Krishnanshu06/hexapud/docs/assets/d_loop_trajectory.png

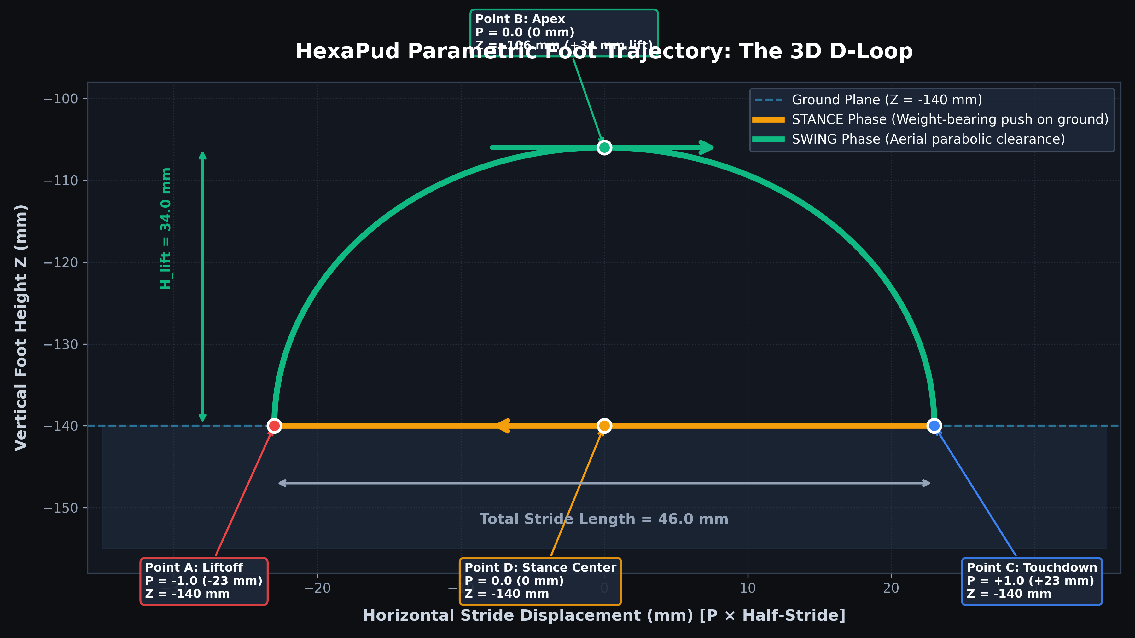
docs/assets/d_loop_trajectory.png
