Krishnanshu06/hexapud/docs/assets/inverse_kinematics_diagram.png

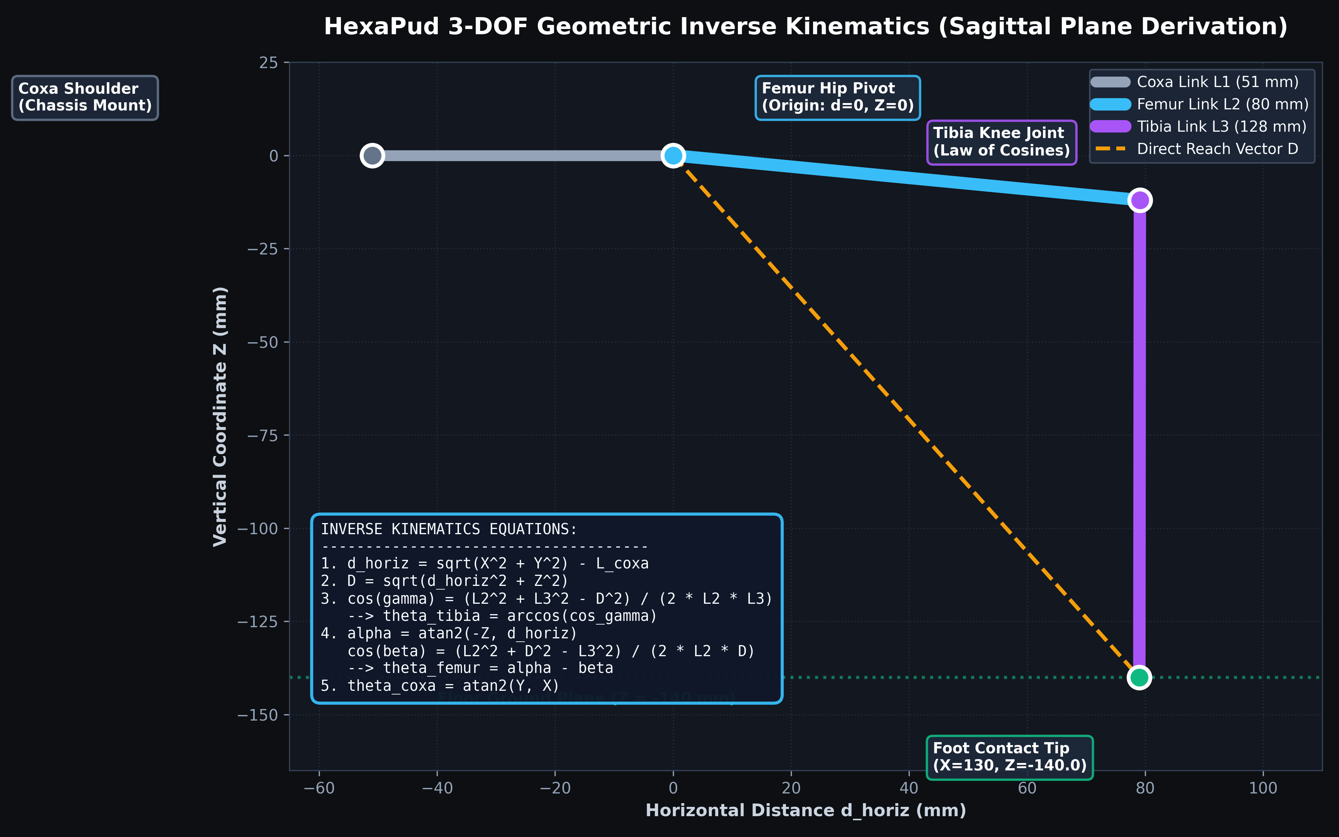
docs/assets/inverse_kinematics_diagram.png
