Krishnanshu06/hexapud/cad/body/body_main_top.3mf

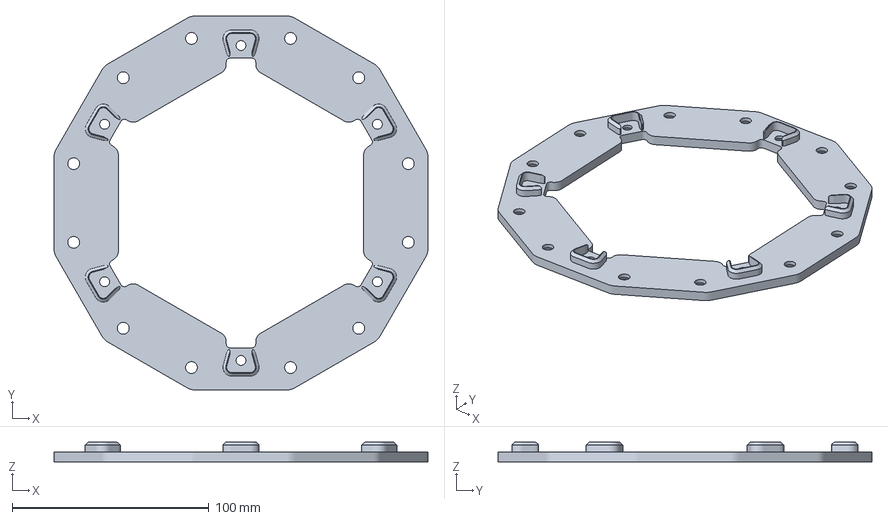
[picture p8: CAD file, 2026-10-30]
cad/body/body_main_top.3mf
190.0 x 190.0 x 10.0 mm
