Krishnanshu06/hexapud/cad/body/body_main_bottom.3mf

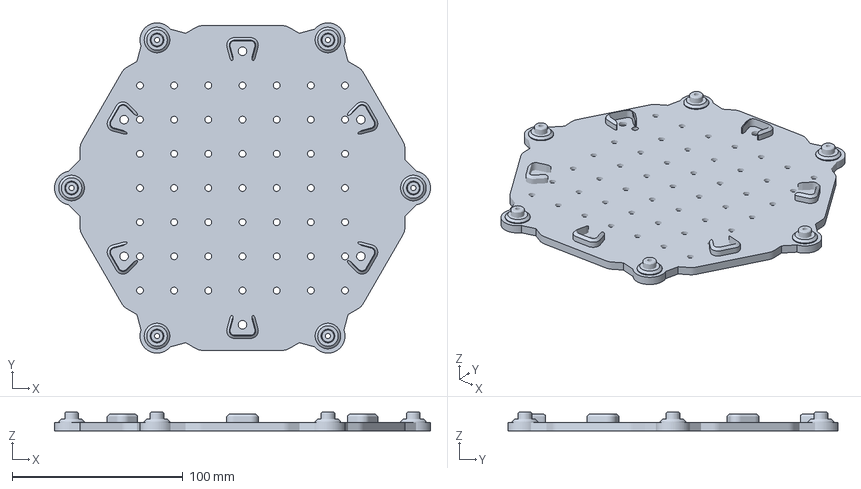
[picture p9: CAD file, 2026-10-30]
cad/body/body_main_bottom.3mf
220.0 x 193.2 x 11.0 mm
