Krishnanshu06/hexapud/cad/body/body_spacer_set.3mf

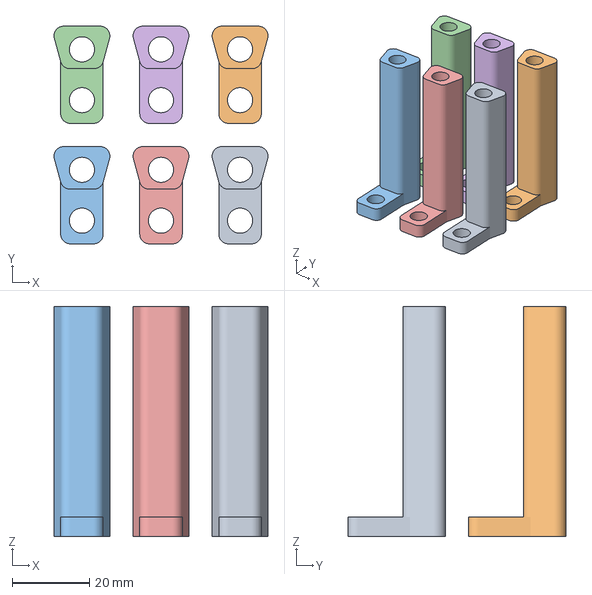
[picture p10: CAD file, 2026-10-30]
cad/body/body_spacer_set.3mf
55.4 x 56.3 x 59.5 mm
