Krishnanshu06/hexapud/cad/legs/common/bushing.stl

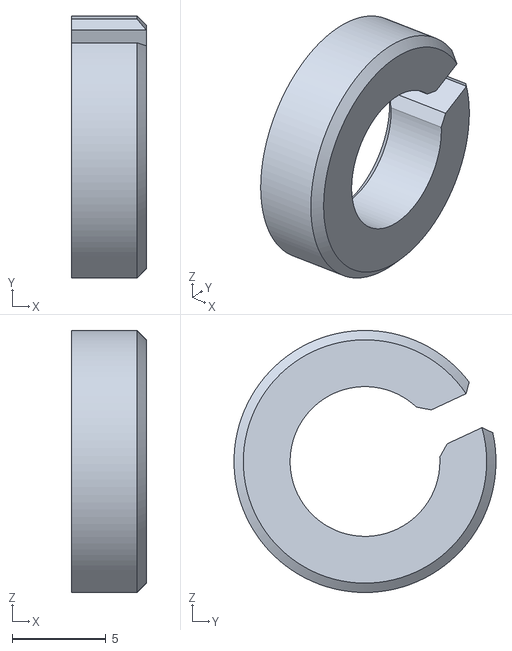
[picture p11: CAD file, 2026-10-30]
cad/legs/common/bushing.stl
4.00 x 14.0 x 14.0
