Krishnanshu06/hexapud/cad/legs/left_leg_mirrored/leg_set_mirrored.stl

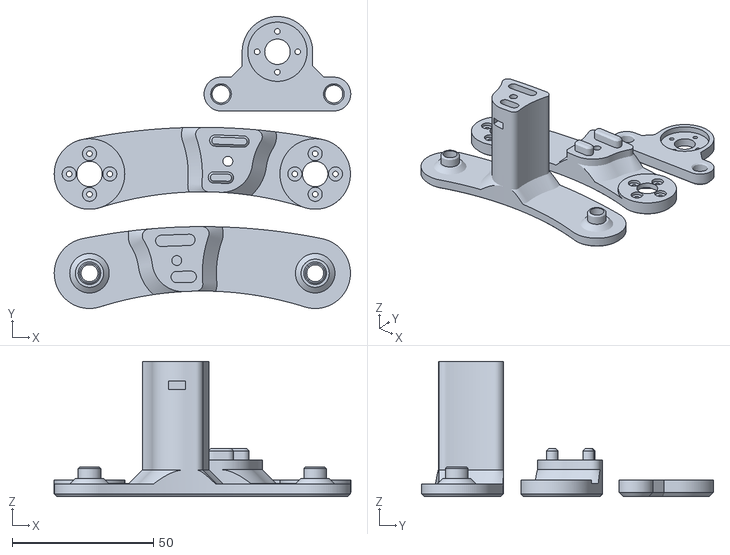
[picture p12: CAD file, 2026-10-30]
cad/legs/left_leg_mirrored/leg_set_mirrored.stl
105.1 x 103.5 x 48.0
