Krishnanshu06/hexapud/cad/legs/right_leg/femurSlimPart.stl

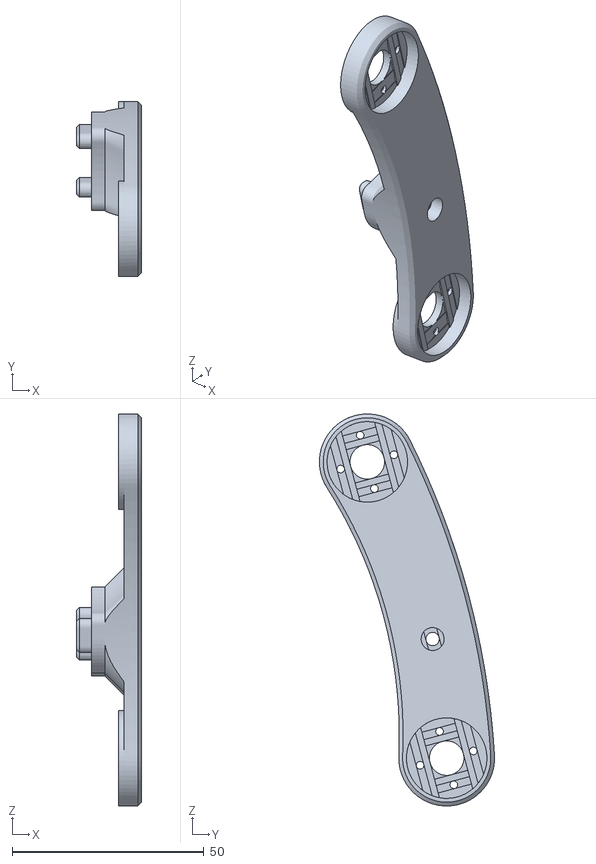
[picture p13: CAD file, 2026-10-30]
cad/legs/right_leg/femurSlimPart.stl
17.0 x 45.7 x 102.2
