Krishnanshu06/hexapud/cad/legs/common/tibia_hollowed.stl

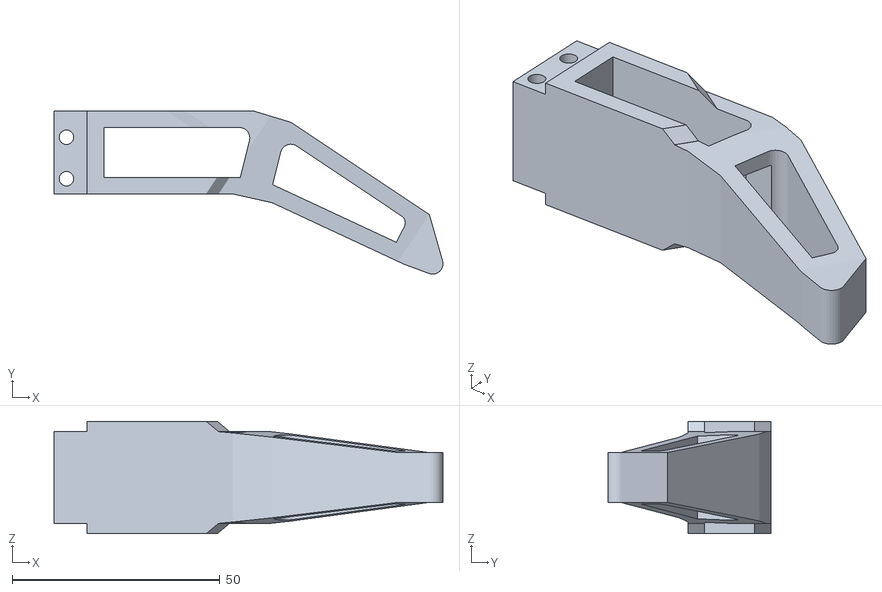
[picture p14: CAD file, 2026-10-30]
cad/legs/common/tibia_hollowed.stl
93.7 x 39.3 x 27.1
