Krishnanshu06/hexapud/cad/legs/left_leg_mirrored/servo_mount_trochanter_mirrored.stl

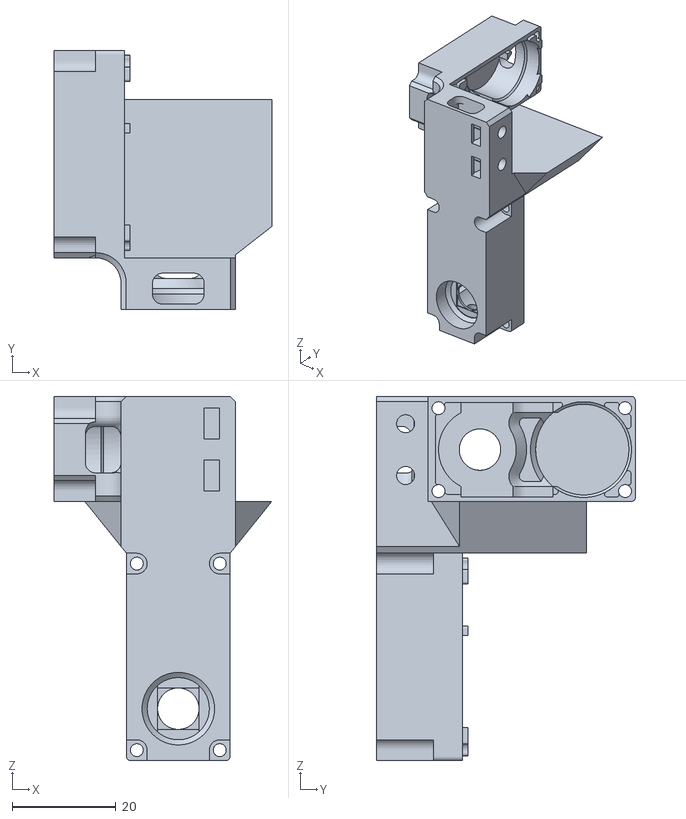
[picture p15: CAD file, 2026-10-30]
cad/legs/left_leg_mirrored/servo_mount_trochanter_mirrored.stl
42.0 x 50.0 x 70.2
