Krishnanshu06/hexapud/cad/legs/right_leg/femurThicPart.stl

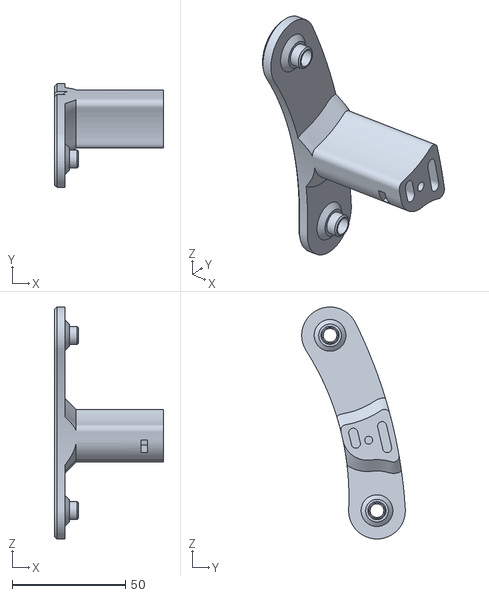
[picture p16: CAD file, 2026-10-30]
cad/legs/right_leg/femurThicPart.stl
48.0 x 45.7 x 102.3
