Krishnanshu06/hexapud/cad/legs/left_leg_mirrored/servo_mount_tibia_mirrored.stl

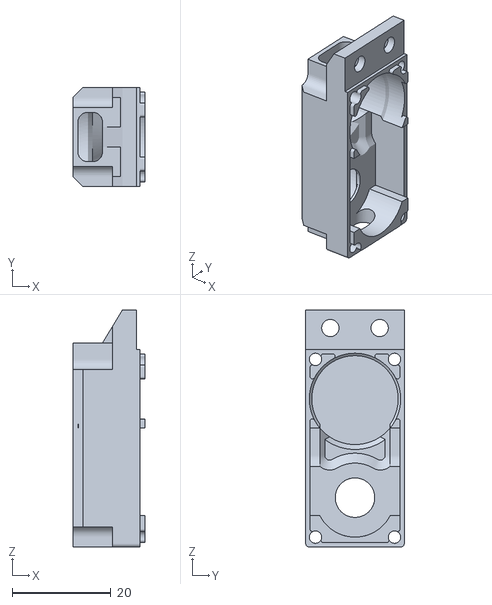
[picture p17: CAD file, 2026-10-30]
cad/legs/left_leg_mirrored/servo_mount_tibia_mirrored.stl
14.6 x 20.0 x 48.0
