Krishnanshu06/hexapud/cad/body/body_lid.3mf

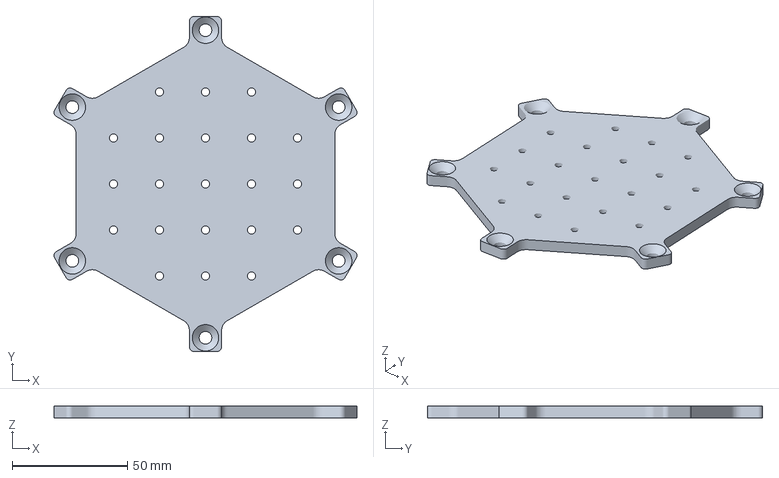
[picture p18: CAD file, 2026-10-30]
cad/body/body_lid.3mf
131.7 x 145.7 x 5.00 mm
