Krishnanshu06/hexapud/cad/legs/right_leg/servo_mount_tibia.stl

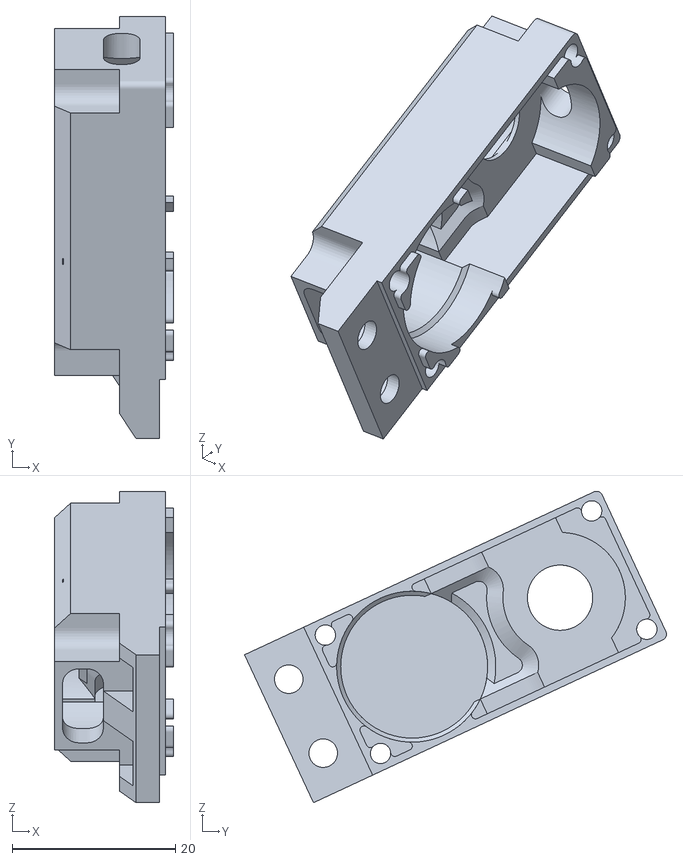
[picture p19: CAD file, 2026-10-30]
cad/legs/right_leg/servo_mount_tibia.stl
14.6 x 51.7 x 38.2
