Krishnanshu06/hexapud/cad/legs/right_leg/coxa.stl

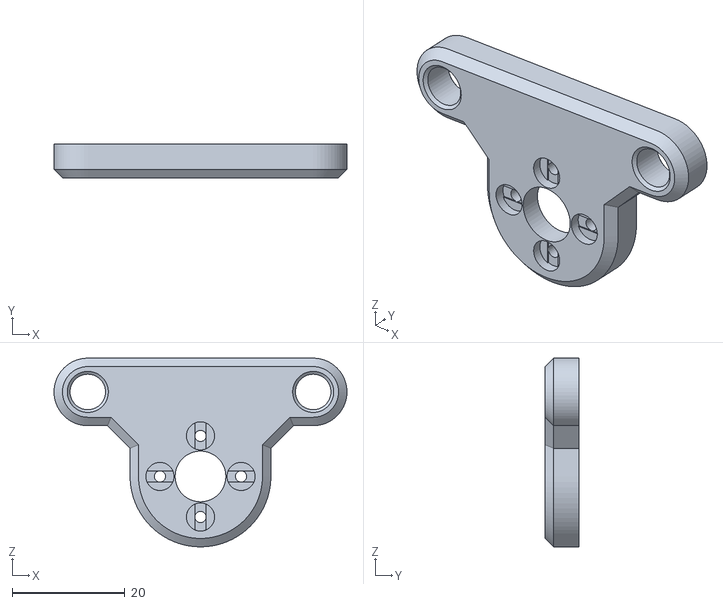
[picture p20: CAD file, 2026-10-30]
cad/legs/right_leg/coxa.stl
52.0 x 6.00 x 33.5
