Krishnanshu06/hexapud/(list of files, cad)

Other CAD files:
cad/legs/right_leg/servo_mount_trochanter.stl
