Krishnanshu06/hexapud/docs/media/complete_assembly_top.jpg

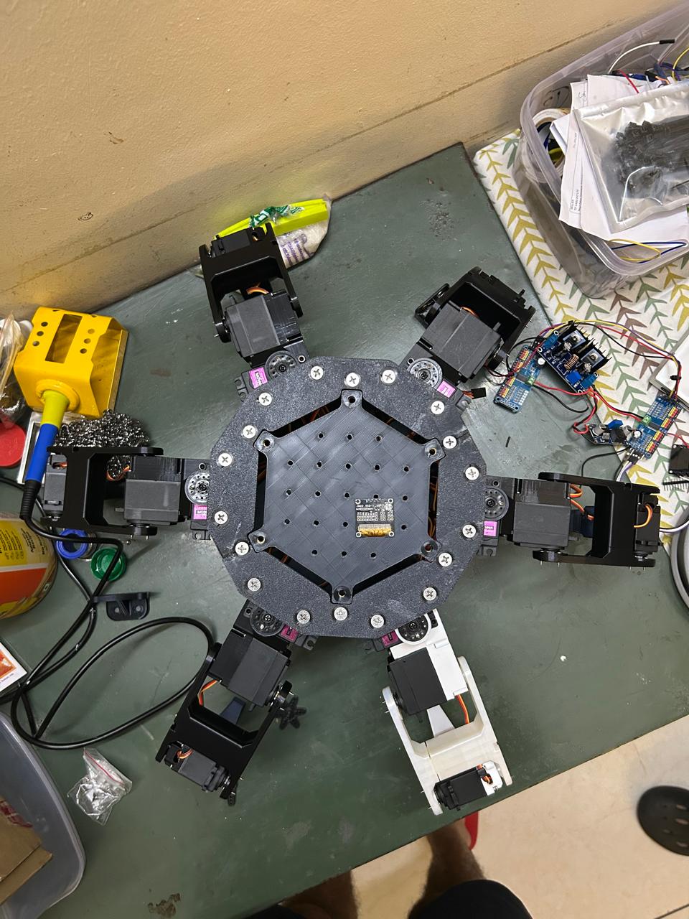
docs/media/complete_assembly_top.jpg
