Krishnanshu06/hexapud/(commit log)

2026-10-30 docs & cad: update battery specs, rupees total, team profile, and organize 3D print models
2026-10-30 cad: update right leg femur parts (femurSlim, femurThic) and mirrored leg set
2026-10-30 docs: remove servo badge and add team contributions navigation button
