Krishnanshu06/hexapud/(notices)

Notices in the files:
README.md:
License: MIT
